iltimasd/From-the-Upside-Down/board.png

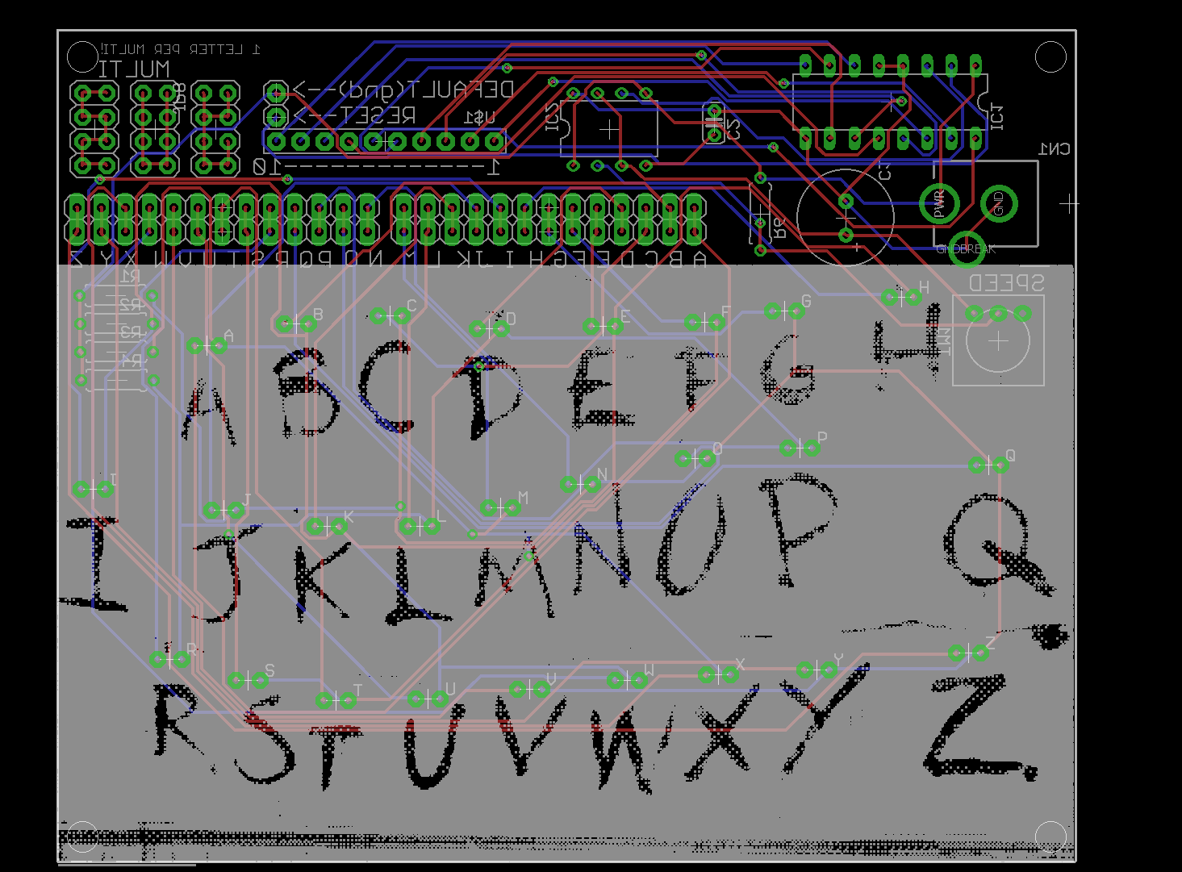
board.png
