iltimasd/From-the-Upside-Down/main.brd

## EAGLE design main.brd (2017-01-13)

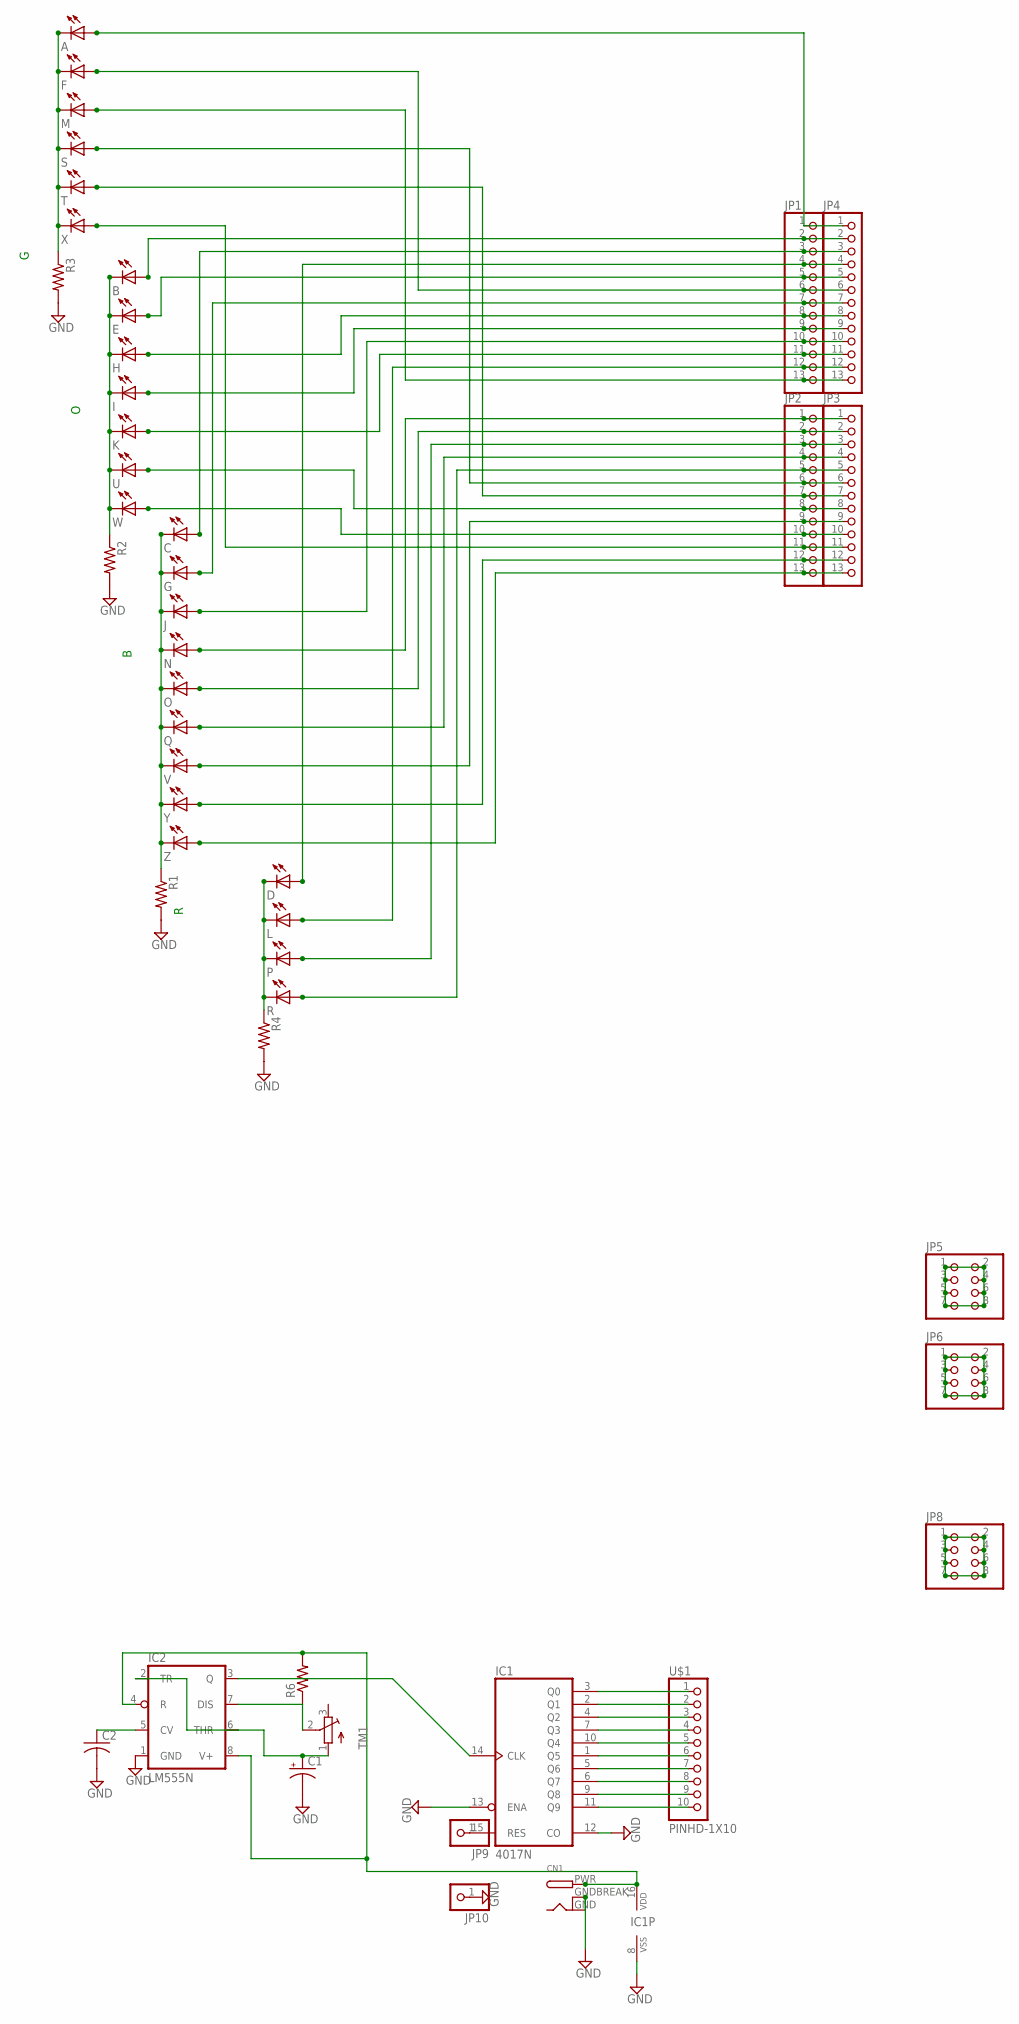
[picture p2: schematic main.sch]

Parts:
A: LED3MM
B: LED3MM
C: LED3MM
C1: CPOL-USE3.5-10; E3,5-10
C2: C-US025-024X044; C025-024X044
CN1: DCBARRELPTH; DCJACK_2MM_PTH
D: LED3MM
E: LED3MM
F: LED3MM
G: LED3MM
H: LED3MM
I: LED3MM
IC1: 4017N; DIL16
IC2: LM555N; DIL08
J: LED3MM
JP1, JP2, JP3, JP4: PINHD-1X13; 1X13
JP5, JP6, JP8: PINHD-2X4; 2X04
JP9, JP10: PINHD-1X1; 1X01
K: LED3MM
L: LED3MM
M: LED3MM
N: LED3MM
O: LED3MM
P: LED3MM
Q: LED3MM
R: LED3MM
R1, R2, R3, R4, R6: R-US_0207/7; 0207/7
S: LED3MM
T: LED3MM
TM1: TRIMPOT3386; TRIM-3386
U: LED3MM
U$1: PINHD-1X10; 1X10-BIG
V: LED3MM
W: LED3MM
X: LED3MM
Y: LED3MM
Z: LED3MM

Connections:
A: A.K (C), F.K (C), M.K (C), R3.1, S.K (C), T.K (C), X.K (C)
GND: C1.-, C2.2, CN1.GND, CN1.GNDBREAK, IC1.8 (VSS), IC1.12 (CO), IC1.13 (ENA), IC2.1 (GND), JP10.1, R1.2, R2.2, R3.2, R4.2
unnamed: B.K (C), E.K (C), H.K (C), I.K (C), K.K (C), R2.1, U.K (C), W.K (C)
unnamed: D.K (C), L.K (C), P.K (C), R.K (C), R4.1
unnamed: IC1.3 (Q0), U$1.1
unnamed: IC1.2 (Q1), U$1.2
unnamed: IC1.4 (Q2), U$1.3
unnamed: IC1.7 (Q3), U$1.4
unnamed: IC1.10 (Q4), U$1.5
unnamed: IC1.1 (Q5), U$1.6
unnamed: IC1.5 (Q6), U$1.7
unnamed: IC1.6 (Q7), U$1.8
unnamed: IC1.9 (Q8), U$1.9
unnamed: IC1.11 (Q9), U$1.10
unnamed: CN1.PWR, IC1.16 (VDD), IC2.4 (R), IC2.8 (V+), R6.2
unnamed: A.A, JP1.1, JP4.1
unnamed: B.A, JP1.2, JP4.2
unnamed: JP1.12, JP4.12, L.A
unnamed: F.A, JP1.6, JP4.6
unnamed: IC1.15 (RES), JP9.1
unnamed: G.A, JP1.7, JP4.7
unnamed: JP2.2, JP3.2, O.A
unnamed: JP1.11, JP4.11, K.A
unnamed: C1.+, IC2.2 (TR), IC2.6 (THR), TM1.1 (A)
unnamed: JP2.3, JP3.3, P.A
unnamed: JP2.12, JP3.12, Y.A
unnamed: JP2.13, JP3.13, Z.A
unnamed: JP5.1, JP5.2, JP5.3, JP5.4, JP5.5, JP5.6, JP5.7, JP5.8
unnamed: JP6.1, JP6.2, JP6.3, JP6.4, JP6.5, JP6.6, JP6.7, JP6.8
unnamed: JP8.1, JP8.2, JP8.3, JP8.4, JP8.5, JP8.6, JP8.7, JP8.8
unnamed: J.A, JP1.10, JP4.10
unnamed: IC2.7 (DIS), R6.1, TM1.2 (S)
unnamed: D.A, JP1.4, JP4.4
unnamed: C2.1, IC2.5 (CV)
unnamed: IC1.14 (CLK), IC2.3 (Q)
unnamed: I.A, JP1.9, JP4.9
unnamed: JP1.13, JP4.13, M.A
unnamed: JP2.1, JP3.1, N.A
unnamed: JP2.4, JP3.4, Q.A
unnamed: JP2.6, JP3.6, S.A
unnamed: JP2.7, JP3.7, T.A
unnamed: JP2.8, JP3.8, U.A
unnamed: JP2.9, JP3.9, V.A
unnamed: JP2.10, JP3.10, W.A
unnamed: JP2.11, JP3.11, X.A
unnamed: JP2.5, JP3.5, R.A
unnamed: H.A, JP1.8, JP4.8
unnamed: E.A, JP1.5, JP4.5
unnamed: C.A, JP1.3, JP4.3
RGND: C.K (C), G.K (C), J.K (C), N.K (C), O.K (C), Q.K (C), R1.1, V.K (C), Y.K (C), Z.K (C)

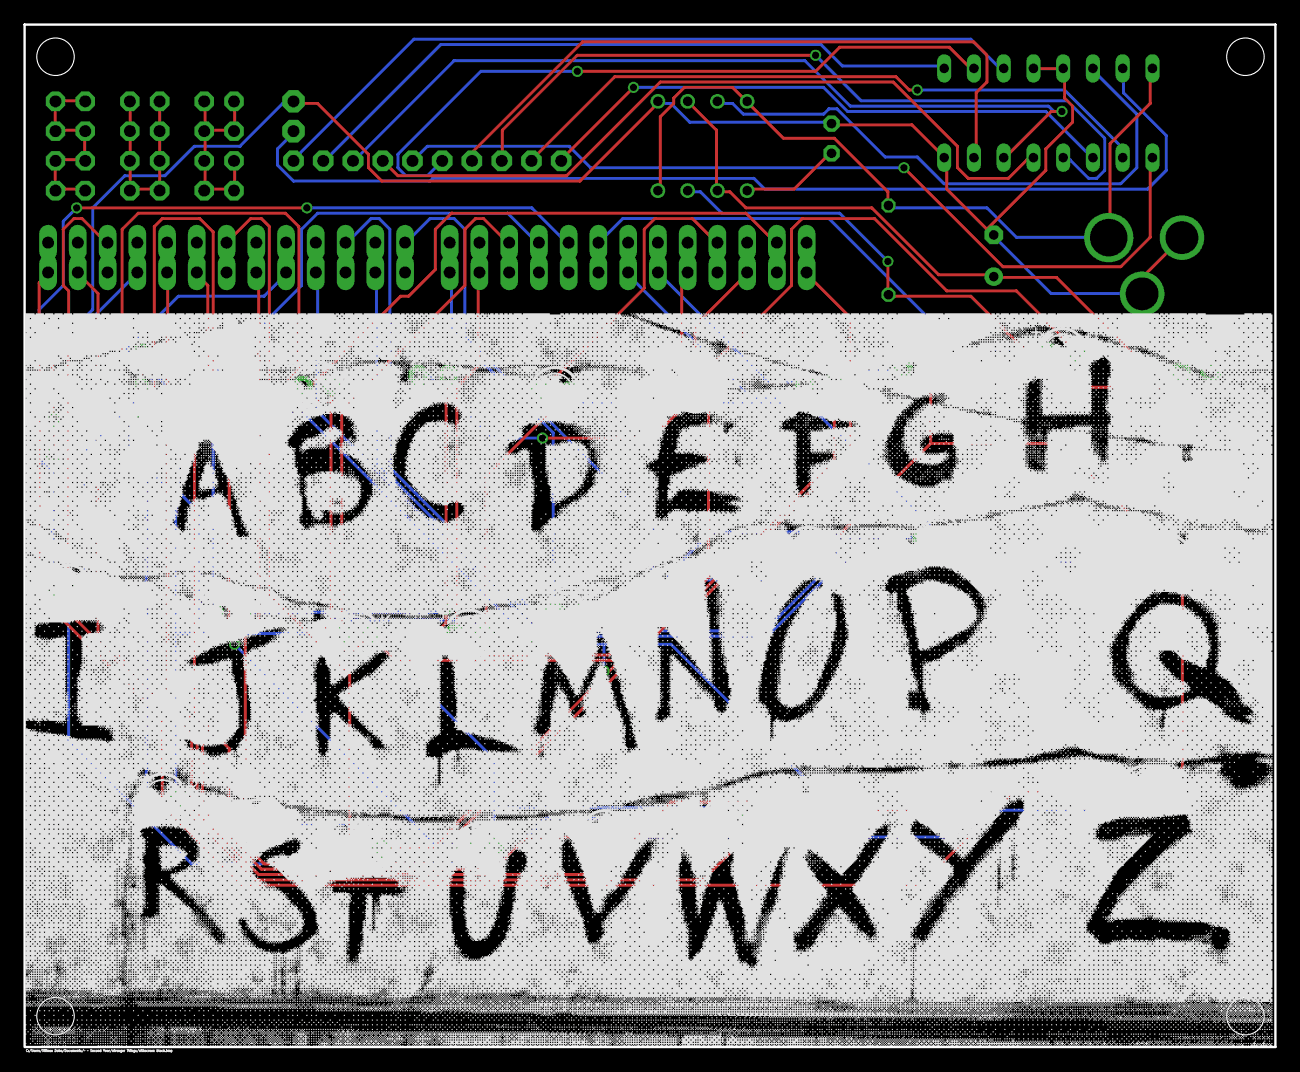
[picture p3: board main.brd from above]

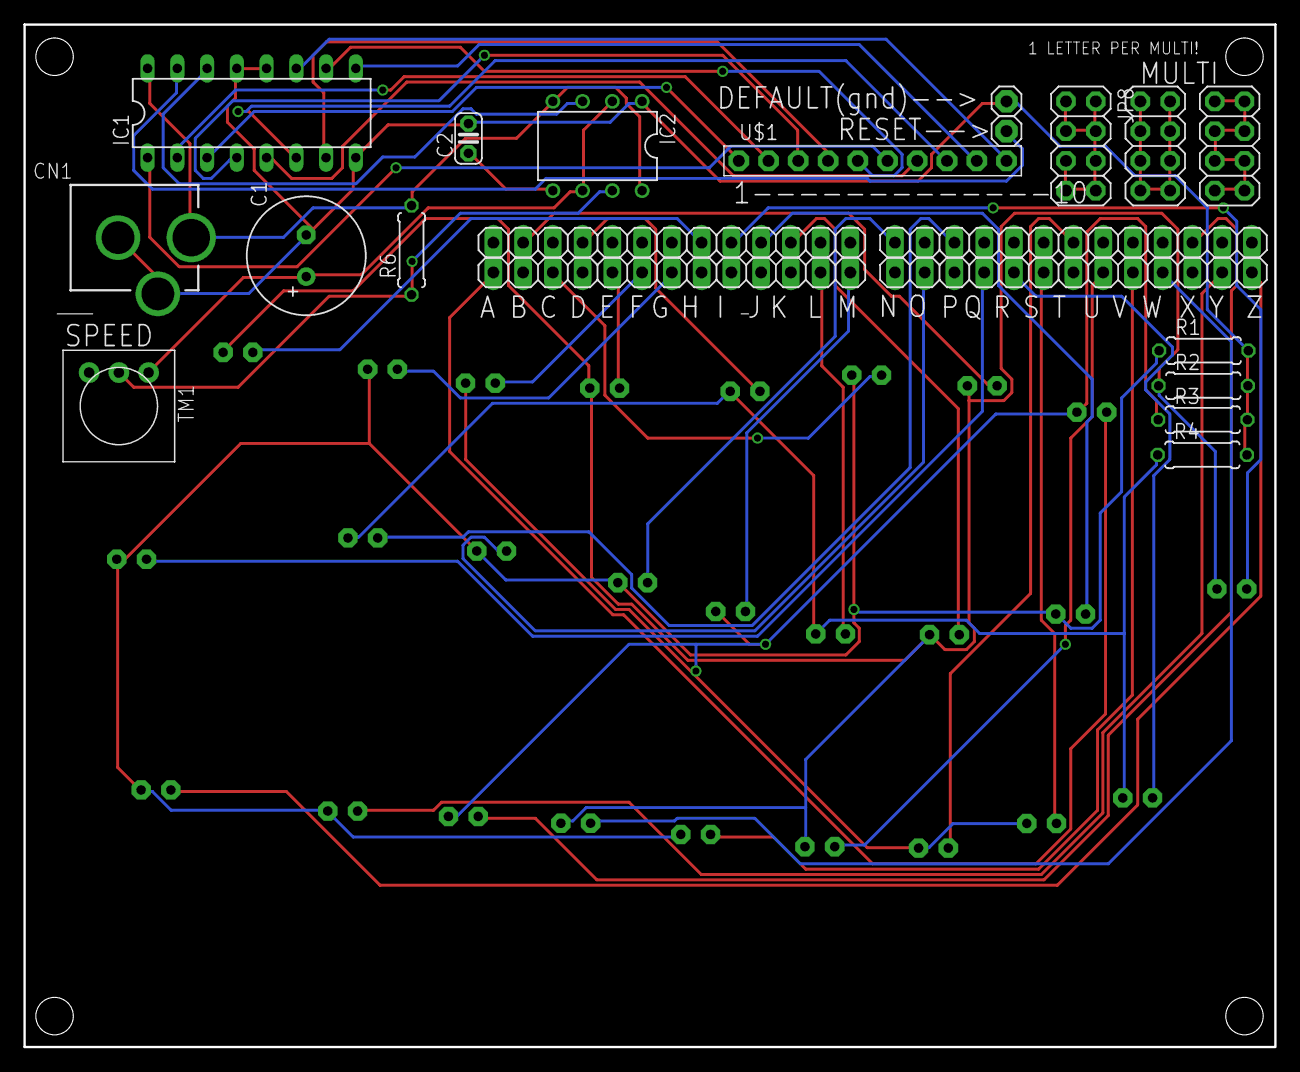
[picture p4: board main.brd from below]

Board: 2 copper layers, 106.8 x 87.3 mm, 47 parts (21 on the bottom side), 50 nets.
